cakama3a/Prometheus82/Box_Papers/box_insert.html

PROMETHEUS 82

# Thank you for choosing Prometheus 82

Every Prometheus 82 unit is personally built and tested before shipping. Each device is verified against a reference unit to make sure it performs as expected.

QR code to the Prometheus 82 setup video Scan for the guide youtu.be/Jr5kND7qLt8

## Before your first test

If you follow the current video guide and place the controller correctly, everything should work properly. The setup shown in the guide reflects the current recommended procedure.

Prometheus 82 requires the Prometheus 82 software. Download the latest release here: github.com/cakama3a/Prometheus82/releases

Power Recommendation: Use a 20W (or higher) power adapter. Weak adapters may cause unpredictable test results.

Each tester is checked before dispatch, including a comparison of measured latency behavior against a known-good reference sample. This helps ensure your unit arrives ready to use.

## Care and long-term reliability

- Let the solenoid cool down after test sessions.
- Use the tester as shown in the guide for the best accuracy and service life.

## If something goes wrong

Hardware failures during use are rare, but they are still possible. If a part wears out or stops working, you can request a replacement part.

Replacement parts are free; you only pay for shipping.

Warranty replacement is valid for one year after receipt.

Please use this support option fairly. It is intended for genuine failures, wear, or accidental issues during normal use, not for repeated abuse, misuse, or damage caused by overheating the solenoid.

Hand-built & Tested

Prometheus 82 Input Latency Tester
github.com/cakama3a/Prometheus82
