cakama3a/Prometheus82/COMMERCIAL_LICENSE.md

# Prometheus 82 — Perpetual Commercial License Agreement

**Last Updated:** October 30, 2026

**Version:** 2.1

**Status: Public standard terms for individually issued commercial licenses.** Publication of this file in a public repository does not grant commercial permission. The legally binding terms applicable to a Licensee are the exact version supplied directly by the Licensor before payment (for example, via email attachment or invoice document), together with any expressly agreed individual variations. Public repository updates do not alter an accepted license.

This Perpetual Commercial License Agreement (the "Agreement") governs commercial use of the Prometheus 82 hardware designs, firmware, software, and documentation (collectively, the "Project"), to the extent the Licensor is authorized to license them.

**Author / Copyright Owner:** John Punch (`john@gamepadla.com`, gamepadla.com).

**Licensor:** The Author, or a representative authorized by the Author to grant these rights and expressly identified as the contracting licensor in the commercial invoice. A representative may grant only rights within that authority.

**Licensee:** The legal entity or individual identified as the customer in the commercial invoice issued by the Licensor.

---

### 1. Acceptance, Payment, and Effective Date

**1.1. Agreement by Payment:** Unless the parties expressly agree otherwise in writing before payment, this Agreement becomes effective upon the Licensor's receipt of full payment of the commercial license fee specified in an invoice that meets Section 1.3 (the "Effective Date").

**1.2. No Signature Required:** Payment of that license invoice constitutes the Licensee's full, unconditional acceptance of the supplied version and any expressly agreed variations. No separate physical or digital signature, bilateral agreement exchange, or additional confirmation is required unless specifically agreed before payment.

**1.3. Supplied Version Precedence:** The commercial invoice or its accompanying correspondence must identify the contracting parties, covered Licensee entities, the one-time license fee, applicable taxes, and the applicable license version and date. The definitive applicable text must be supplied directly to the Licensee before payment as an attachment (e.g., PDF or Markdown file) or within the invoice correspondence. The directly supplied text governs and takes precedence over any public repository file or branch (including `main`). An invoice that does not supply the applicable terms must be clarified before payment.

**1.4. No Permission from Preliminary Steps:** Unpaid invoices, preliminary discussions, receipt of this template, downloading repository files, and the purchase of hardware alone do not grant commercial permission.

---

### 2. Definitions and Perpetual Term

**2.1. The Project:** The Author-controlled Prometheus 82 hardware designs (including CAD/STL files), firmware, software, calibration data, and documentation publicly released at https://github.com/cakama3a/Prometheus82 on or before the Effective Date, together with subsequent Author-controlled updates publicly released there as part of Prometheus 82. Separately offered successor products, private designs, and rights belonging to third parties are not included except as separately authorized.

**2.2. Commercial Use:** Any use of the Project for commercial advantage, monetary gain, or business operations, including but not limited to product research and development (R&D), internal quality assurance (QA), competitive benchmarking, marketing, packaging claims, comparative advertising, and monetized media content creation.

**2.3. Perpetual Term:** The license granted hereunder is **perpetual, worldwide, and non-exclusive**. There are no annual renewal fees, recurring subscription charges, per-test or per-controller royalties, or periodic compliance audits. It remains in force indefinitely, subject only to termination under Section 10.

---

### 3. Grant of Rights

Subject to the terms of this Agreement and payment of the applicable fee, the Licensor grants the Licensee a perpetual, worldwide, non-exclusive license to:

- **Deploy & Use:** Install, configure, integrate, and execute the Project internally for Commercial Use across unlimited workstations and testing facilities owned or operated by the Licensee.
- **Modify:** Adapt, customize, alter, or reconfigure the firmware, software, CAD models, wiring schemas, and calibration routines for internal business requirements.
- **Scale Internally:** Construct, 3D-print, assemble, and operate additional Project-based testing units for internal company use without paying additional per-unit license fees.
- **Personnel & Contractors:** Authorize employees and bona fide contractors to operate the Project solely on the Licensee's behalf, provided the Licensee remains responsible for their compliance.
- **Maintain Confidentiality or Publish:** Keep all measurements, internal procedures, evaluation frameworks, and proprietary adaptations strictly confidential, or publish resulting data at the Licensee's sole discretion.

For the internal activities authorized by this Agreement, the Licensee does not need prior approval and has no obligation under this Agreement to publish results or modifications, or to supply internal code or methods to the Author. Applicable third-party license obligations remain unaffected.

This is an alternative commercial permission. For activities it authorizes, the non-commercial-use restriction and prominent user-interface attribution condition in the Personal Use License do not apply. Existing copyright and applicable license notices must remain in retained Project copies; this does not require credit in measurement reports.

---

### 4. Fees, Hardware Transactions, and Scope of Service

**4.1. One-Time Fee:** The license fee is a customized, one-time payment set out in the invoice. Once settled, no future license fees, royalties, or renewal charges will be demanded for the covered Project.

**4.2. Hardware as a Separate Transaction:** Physical evaluation stands, testing hardware, spare parts, and associated shipping are independent transactions handled separately from this intellectual property license. Issues regarding physical shipments—including transit delays, carrier loss, transit damage, or customs clearance procedures—are governed by the terms of the applicable equipment order or carrier policy and do not alter, revoke, or invalidate the granted commercial license. Physical items are delivered subject to the recipient paying any applicable local import duties, taxes, or clearance fees. Specific equipment terms, pricing, shipping arrangements, and replacement policies are established in the respective hardware invoice or correspondence.

**4.3. No Ongoing Support Obligations (Self-Service):** The license fee covers permission to use the Project; it **does not** include dedicated technical support, troubleshooting, individual onboarding, custom firmware development, repair services, periodic recalibration, response deadlines, or service level agreements (SLAs). Usage guidance is based on publicly available documentation and self-service guides. Voluntary assistance does not by itself create a continuing support duty or an SLA. Any guaranteed service requires a separate express written agreement.

**4.4. Development Continuity & Updates:** The Licensee is entitled to use any future public Prometheus 82 updates released by the Author. However, the Licensor and Author have no contractual obligation to maintain continuous development, support future game controllers/protocols, fix issues, or ensure perpetual hosting of repositories, documentation, or companion websites. Discontinuation of the Project does not affect the Licensee's perpetual right to use covered copies already obtained. This section does not remove mandatory legal rights or obligations under a separate equipment or service agreement.

---

### 5. Underlying Project and Third-Party Rights

**5.1. Underlying Project:** The Author retains the intellectual property rights in the original, Author-owned Project material. This Agreement grants permission to use and modify the Project; it does not transfer ownership of the underlying Project.

**5.2. Third-Party Components:** Third-party components, libraries, and assets remain governed by their respective licenses. Nothing in this Agreement restricts or overrides independently granted third-party rights or removes applicable notice, attribution, source-disclosure, or distribution obligations.

---

### 6. Retained Restrictions

**6.1. No Onward Distribution or Resale:** This Agreement does not grant permission to sell, lease, sublicense, or distribute the Project or Project-based testing devices to third parties, or to incorporate Project code or designs into customer products, without a separate written distribution agreement from the Licensor. Independently granted third-party rights under Section 5.2 remain unaffected.

**6.2. No Sublicensing:** The Licensee may not sublicense the commercial rights granted under this Agreement to external entities or subsidiaries not expressly covered in the commercial invoice.

---

### 7. Results, Attribution, and Marketing

**7.1. Voluntary Attribution:** Attribution to Prometheus 82 is **entirely optional**. The Licensee may publish benchmarks, comparative graphs, packaging claims, or reviews without crediting the Project or the Author. If the Licensee chooses to provide credit, truthful statements such as *"Latency measured using Prometheus 82"* or references to `gamepadla.com` are permitted.

**7.2. Commercial Independence & Data Accuracy:** The Licensee is solely responsible for the technical accuracy and integrity of its measurements. The Licensee shall not present results in a manner that falsely implies formal certification, warranty, or official endorsement by the Author or the Prometheus 82 project. No automatic "Certified" badge rights are granted by this Agreement.

**7.3. Mutual Brand Protection:** Neither party may use the other party's trade names, trademarks, or corporate logos in public marketing, press releases, or client lists without prior written permission, except for truthful factual statements expressly permitted under Section 7.1 (such as *"Latency measured using Prometheus 82"*). That exception does not grant logo or certification-badge rights. Private processing of customer names for accounting, invoicing, and license administration is permitted.

---

### 8. Disclaimer of Warranty

TO THE MAXIMUM EXTENT PERMITTED BY APPLICABLE LAW, THE PROJECT AND ALL ASSOCIATED MATERIALS ARE PROVIDED ON AN **"AS IS" AND "AS AVAILABLE" BASIS**, WITHOUT WARRANTY OF ANY KIND, EXPRESS OR IMPLIED, INCLUDING BUT NOT LIMITED TO WARRANTIES OF MERCHANTABILITY, FITNESS FOR A PARTICULAR PURPOSE, TITLE, ACCURACY, AND NON-INFRINGEMENT. THE LICENSEE ASSUMES FULL RESPONSIBILITY AND RISK FOR TESTING PROCEDURES, HARDWARE FABRICATION, DATA ACCURACY, AND BUSINESS DECISIONS DERIVED FROM THE USE OF THE PROJECT.

---

### 9. Limitation of Liability

TO THE MAXIMUM EXTENT PERMITTED BY APPLICABLE LAW, IN NO EVENT SHALL THE LICENSOR OR THE AUTHOR BE LIABLE FOR ANY INDIRECT, INCIDENTAL, SPECIAL, CONSEQUENTIAL, OR PUNITIVE DAMAGES, INCLUDING LOSS OF PROFITS, DATA LOSS, EQUIPMENT DAMAGE, OR BUSINESS INTERRUPTION, ARISING OUT OF OR IN CONNECTION WITH THIS AGREEMENT OR THE USE OF THE PROJECT.

THE AGGREGATE LIABILITY OF THE LICENSOR AND THE AUTHOR ARISING OUT OF OR RELATED TO THIS AGREEMENT SHALL BE STRICTLY LIMITED TO THE ACTUAL LICENSE FEE PAID BY THE LICENSEE UNDER THE APPLICABLE INVOICE.

The exclusions and aggregate monetary limit above are subject to the following exception: nothing in this Agreement excludes or limits liability for fraud, fraudulent misrepresentation, death or personal injury caused by negligence, or any liability that cannot lawfully be excluded or limited under applicable law.

These limitations do not permit the Licensor to withdraw the perpetual license for convenience or impose later renewal charges.

---

### 10. Termination

**10.1. Termination for Material Breach:** The Licensor may terminate this license only in the event of a material breach of this Agreement by the Licensee that remains uncured after thirty (30) days of written notice specifying the breach.

**10.2. Non-Grounds for Termination:** Because this Agreement imposes no such obligations, termination cannot be invoked on grounds of failure to display attribution, non-publication of results, lack of support purchases, or discontinuation of public repository hosting.

**10.3. Effect of Termination:** Upon valid termination, the Licensee must cease further use of the Project for commercial purposes. Lawfully published results, historical reports, and packaging materials created prior to termination remain valid and require no retraction or destruction.

---

### 11. Governing Law and Amendments

**11.1. Governing Law:** This Agreement shall be governed by and construed in accordance with the laws of **England and Wales**, without regard to conflict-of-law principles.

**11.2. Fixed Terms, Precedence, and Modification:** The exact license text supplied directly before payment under Section 1.3, the commercial details in the paid invoice, and any expressly agreed individual variations form the agreement for that Licensee. Individually agreed variations prevail over conflicting standard terms. Later changes to a website, repository file, or public template do not amend an accepted license. Any subsequent amendment requires express written agreement by both parties; neither a unilateral message nor silence is an amendment.

**11.3. Prior Agreements and Earlier Use:** This version does not automatically replace or amend any earlier license agreement, authorize use before the Effective Date, or release claims relating to prior use. Any amendment of an earlier agreement or resolution of prior use requires a separate express agreement identifying its scope.

---

### 12. Contact Information

For commercial license inquiries, invoice requests, or custom distribution inquiries, contact:

- **John Punch**
- **Email:** `john@gamepadla.com`
- **Website:** `https://gamepadla.com`
- **Repository:** `https://github.com/cakama3a/Prometheus82`
