cakama3a/Prometheus82/Arduino.ino

const int CONTACT_PIN = 3;
const int SOLENOID_PIN = 2;
unsigned long PULSE_DURATION_US = 40000;

volatile bool windowActive = false, contactDetected = false, solenoidActive = false;
volatile unsigned long solenoidStartTime_us = 0;

void handleContact() {
    if (!windowActive) return;
    if (!contactDetected) {
        Serial.write('S');
        contactDetected = true;
        return;
    }
}

void setup() {
    Serial.begin(115200);
    pinMode(CONTACT_PIN, INPUT_PULLUP);
    pinMode(SOLENOID_PIN, OUTPUT);
    const char* FWV = "1.1.1";
    
    attachInterrupt(digitalPinToInterrupt(CONTACT_PIN), handleContact, FALLING);
    
    for (int i = 0; i < 3; i++) {
        digitalWrite(SOLENOID_PIN, HIGH);
        delay(PULSE_DURATION_US / 1000);
        digitalWrite(SOLENOID_PIN, LOW);
        delay(200);
    }
    Serial.write('R');
    Serial.write('V');
    for (int i = 0; FWV[i] != 0; i++) {
        Serial.write(FWV[i]);
    }
    Serial.write('\n');
}

void loop() {
    if (Serial.available() > 0) {
        char cmd = Serial.read();
        
        // Fast handling of 'D' command for delay test
        if (cmd == 'D') {
            Serial.write('R');
            return; // Exit to avoid further checks
        }
        
        // Other commands are processed as before
        if (cmd == 'T') {
            contactDetected = false;
            digitalWrite(SOLENOID_PIN, HIGH);
            solenoidStartTime_us = micros();
            solenoidActive = true;
            windowActive = true;
        }
        else if (cmd == 'P') {
            unsigned long startTime = millis();
            while (Serial.available() < 2 && (millis() - startTime) < 50) {
                ;
            }
            if (Serial.available() >= 2) {
                unsigned long duration_ms = (Serial.read() << 8) | Serial.read();
                PULSE_DURATION_US = duration_ms * 1000;
                Serial.write('A');
            }
            while (Serial.available() > 0) {
                Serial.read();
            }
        }
        else if (cmd == 'Q') {
            int state = digitalRead(CONTACT_PIN);
            Serial.write(state == LOW ? 'H' : 'U');
        }
    }

    if (solenoidActive && (micros() - solenoidStartTime_us >= PULSE_DURATION_US)) {
        digitalWrite(SOLENOID_PIN, LOW);
        solenoidActive = false;
    }
}
