cakama3a/Prometheus82/(commit log)

2025-04-16 Arduino Hex Added
2025-07-05 Update
    Algorithm for testing your own delay for Arduino
2025-07-07 SLC
    Self Latency Calibration
2025-07-12 5.2.2.0
    The basic logic of solenoid timing compensation
2025-07-25 Change test speed
    Change the number and speed of tests so that the overheating of the solenoid has less impact on the final results.
    [Python.py]
2025-07-29 Driver name
2025-07-29 RAW samples
2025-07-29 Filter change
2025-07-29 5.2.3.1
    Update to version 5.2.3.1:
    - Added hardware test mode for solenoid and sensor functionality
    - Reduced TEST_ITERATIONS from 500 to 400
    - Adjusted quantile filters (LOWER_QUANTILE: 0.05->0.02, UPPER_QUANTILE: 0.95->0.98)
    - Added CSV export functionality for test results
    - Improved test type selection with hardware test option
    - Added warning for high contact delay (>1.2ms)
    - Optimized serial connection handling with context manager
    - Included raw results in CSV export
    - Minor code refactoring and cleanup
2025-10-19 Revert "Keyboard And Mouse Test Support"
    This reverts commit abd7da608dad43328bead8c553c99696cdcb16ec.
    [Python.py]
2025-10-19 5.2.3.3
    Stable version fix
    [Python.py]
2025-12-10 Update gamepad testing instructions in README
    Added important note about stick tension adjustment and updated test program instructions.
2026-01-22 5.2.4.3
    An update that adds a separate reversible solenoid for testing the stick. For previous devices with a single test solenoid, use this branch: https://github.com/cakama3a/Prometheus82/tree/One_Solenoid
2026-01-22 Update README with 2026 sensor and solenoid details
    Added information about the new sensor and solenoid for testing sticks in 2026, along with a link to the latest stable release for older versions.
2026-01-22 Clarify missing files for Prometheus 82
    Added note about missing STL file for reverse sensor and case.
2026-01-22 Update README with case STL file clarification
    Clarified the note about STL files for the P82 board case in the README.
2026-01-23 Enhance README with assembly components information
    Added details about individual 3D printed parts and main electronic components.
2026-01-23 Revise Thingiverse link description in README
    Updated the link description for the 3D printed parts.
2026-01-27 5.2.4.4
    Note: reverse sensor
    [Python.py]
2026-02-05 Update video instructions link in README
    Updated video instructions link for the new reversible solenoid.
2026-02-05 Add reversible sensor components section to README
    Added a section for reversible sensor components with details on various components, their prices, and links.
2026-02-05 Revise reversible sensor components section
    Updated the section on reversible sensor components to improve clarity and organization.
2026-03-14 Not Full deflect Error
    [Python.py]
2026-03-14 Update README with user guide and 2026 sensor info
    Added a user guide link and updated information about a new sensor and solenoid layout for 2026.
2026-03-19 Revise sensor trigger and update calculation method
    Updated sensor trigger description and removed manual offset calculation note. Added important update regarding new hardware design.
2026-03-19 Update README with link to Arduino IDE
2026-04-07 Add thank-you page and ignore __pycache__
    Add a printable thank-you HTML (box_insert.html) and a Thank You.pdf for customers. Remove committed Python bytecode (__pycache__/Python.cpython-312.pyc) and update .gitignore to ignore the __pycache__ directory to prevent future pyc files from being tracked. The HTML includes QR/support links and purchase/care information for Prometheus 82.
2026-04-07 Use separate cooling timers for button and stick
    Introduce per-test-type cooling state: create _TEMP_DIR and separate LAST_TEST_TIME_FILE_BUTTON / LAST_TEST_TIME_FILE_STICK files. Update check_cooling_period to accept an optional test_type (aggregating warnings when None, or reporting specific remaining time for BUTTON/STICK). Make get_cooling_remaining_seconds and save_test_completion_time accept test_type and read/write the appropriate file; save_test_completion_time now logs which timer was set. Update main usage to pass test_type when checking and saving cooling state. Handles legacy file formats and IO errors as before.
    [Python.py]
2026-05-06 Dynamic Switching to stronger pulse
2026-05-06 Обмеження тестів при повільному стронг режимі до 200
2026-05-11 Refactor cooling checks and clean up flow
    Centralize cooling-time logic by using get_cooling_remaining_seconds() instead of duplicating file parsing in check_cooling_period(), simplifying both the multi-type and single-type branches and printing consolidated warnings. Broadened exception handling in check_cooling_period to always return True on error. Removed redundant close_test_window() calls and an empty method, and simplified detect_gamepad_mode to delegate to detect_input_mode (removed unused MODES). Cleaned up several blank-line prints in the ASCII header and minor whitespace/flow refinements.
    [Python.py]
2026-05-11 Refactor UI and consolidate timeout limits
    Add a general MAX_CONSECUTIVE_TIMEOUTS constant and unify timeout handling so tests use a type-specific limit (stick vs other). Revamp render_test_window with a new dark-themed UI: header, status text, progress bar, larger average-latency display and a live indicator. Improve and consolidate the error message shown when too many consecutive timeouts occur. These changes improve usability and make test-abort behavior clearer and safer across different test types.
    [Python.py]
2026-05-11 Enhance UI and pre-render background
    Update Python.py to improve the app's UI, visuals and rendering efficiency. Changes include: added math import; new _bg_surface attribute and _pre_render_bg() to pre-render static background/header; revamped start screen (larger title, animated glow, gradient background, updated button and fonts); redesigned render_test_window with header/card layout, animated progress bar, latency dashboard (big average display, stats), and a redesigned LIVE badge; adjusted status messages and key-selection display; and changed the render loop to skip rendering while measuring to preserve measurement accuracy. These changes reduce per-frame drawing cost and improve prese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
    [Python.py]
2026-05-11 Use protocol-aware axis pairing for joysticks
    Replace the simple even/odd partner-axis heuristic with protocol-aware axis pairing used by Stick Tracer. Adds INPUT_MODE_AXES and INPUT_MODE_AXIS_PAIRS tables and updates LatencyTester to look up partner_axis from the detected input mode (self._detected_mode), falling back to the even/odd heuristic if no pair matches. Also adds a brief docstring note about Stick Tracer standard and preserves existing behavior when partner axis cannot be resolved.
    [Python.py]
2026-05-11 Add protocol-aware detection and axis pairing
    Introduce protocol support to LatencyTester by adding an optional protocol parameter and storing it for protocol-aware axis pairing. Refactor input detection: simplify detect_input_mode signature and logic (consolidate Switch detection, rename axes param, add docstring) and remove the old INPUT_MODE_AXES mapping. Update INPUT_MODE_AXIS_PAIRS to include a Default fallback and use the stored protocol when resolving partner axes. Simplify joystick warmup in detect_gamepad_mode and pass the detected_mode into LatencyTester when constructing the tester to enable protocol-specific behavior.
2026-05-11 5.2.5.0
    UI and Visuals
    New Testing Window: Redesigned the testing interface with a better layout and a real-time results dashboard.
    Progress Indicators: Added a visual progress bar and "LIVE/FINISHED" status badges.
    Cooling Dashboard: Replaced the simple text warning with a formatted status box in the console to track solenoid cooling time.
    Measurement Accuracy
    Process Priority: The app now automatically sets itself to High Priority on Windows during testing to reduce OS interference.
    Jitter Reduction: Python's Garbage Collector is now disabled during the measurement phase to prevent random latency spikes.
    Loop Optimization: The testing loop is more efficient, separating high-speed data coll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
    [Python.py]
2026-05-14 Keep Pygame responsive during console input
    Bump version to 5.2.5.1 and add LAST_RENDER_CALL to allow background rendering while waiting for console input. Extend get_input_with_countdown(prompt, menu=None, show_cooling=True) to optionally disable cooling display and to pump Pygame events (calling LAST_RENDER_CALL) so the Pygame window remains responsive. Update LatencyTester to set LAST_RENDER_CALL and change post-test behavior so the window no longer blocks the console: log completion messages instead of waiting for window close, and keep rendering available for background updates. Replace several blocking input() calls with get_input_with_countdown(..., show_cooling=False) to avoid interf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
    [Python.py]
2026-05-14 Require 200 samples before upload; clarify prompt
    Clarify the test start message and enforce a minimum sample requirement for uploading results to Gamepadla.com. Changes: - Update test window prompt to instruct user to switch to the graphical window and press START TEST. - Grey out "Open on Gamepadla.com" when results were already uploaded or when there are fewer than 200 valid samples. - Add a runtime guard that prevents uploading when stats['valid_samples'] < 200 and prints an explanatory error/guidance message.
    [Python.py]
2026-05-14 Add max_len to get_input_with_countdown
    Introduce an optional max_len parameter to get_input_with_countdown to limit input length. On non-Windows platforms input is truncated to max_len; in the interactive loop printable chars are only appended while under the limit and stdout is flushed after each char. Small UI tweaks: replaced a raw print with print_info when the test window is ready, removed a duplicate startup prompt, updated the gamepad-name prompt to indicate a 60-char limit, enforce non-empty gamepad names (print_error on empty), and separate/validate the connection choice mapping. These changes tighten input handling and improve feedback for the test setup flow.
    [Python.py]
2026-05-22 5.3.0.0 - Refactor input/timing and harden latency measurement
    Decouple and robustly handle Arduino 'S' (sensor) and gamepad 'G' timestamps: capture both as absolute microsecond timestamps, track per-cycle state (_cycle_active, _s_received, _g_received) and compute latency as G - S plus contact_delay. Flush serial input before firing the solenoid to discard stale 'S' bytes and replace event-based joystick/button/key detection with lightweight polling (pygame.event.clear, get_button/get_pressed/get_axis) to avoid missed inputs and queue overflow. Add dynamic glitch detection and rejection (based on running average/jitter), improved timeout and consecutive-miss handling, and mark early gamepad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
    [Python.py]
2026-06-06 Add Steam Controller Direct HID support
    Bump version to 5.3.0.1 and add direct Steam Controller (SC2026) HID support via a new SteamControllerDirect class. Gracefully import the optional Python 'hid' package and provide device discovery, diagnostics, feature/heartbeat commands, input parsing (axes/buttons) and helper labels/IDs. Integrate the direct controller into LatencyTester (poll/update paths for axis/button/hit detection), auto-select the first Steam device if present, and print diagnostic tips when no devices are found. Add clear_console_key_buffer for Windows to avoid stray key presses in input loops and improve menu input handling. Map the detected "Steam Direct" protocol to a serve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
    [Python.py]
2026-06-11 Improve gamepad selection and Steam Direct support
    Collect available inputs into a unified options list (SteamControllerDirect and pygame joysticks), present a single selection menu, and handle zero/one/multiple device cases. Add clearer diagnostics and tips when no devices are found or hid is missing, improve input validation and error messages, and defer opening the Steam Direct device until it is actually selected. Ensure selected device is initialized and print whether it was autoselected or chosen by the user.
    [Python.py]
2026-07-01 Add warm-up round to latency testing
    Implement a calibration round that is excluded from measurement counts. The first iteration (i=0) now serves as a warm-up and does not contribute to invalid measurement counts. Similarly, the first timeout encountered is ignored. This helps stabilize measurements by allowing the system to settle before recording actual test results.
    [Python.py]
2026-07-07 Organize box materials and add positioning guide
    Move box_insert.html to Box_Papers directory and add positioning guide assets (PNG and PDF). Includes a Python script to generate a combined PDF guide. Update README to reference the positioning guide in setup instructions and tip section.
2026-07-07 Refine box insert layout and typography
    Adjust CSS dimensions and font sizes in box insert design:
    - Reduced font sizes: ascii-title (7.5px → 6.2px), h1 (22px → 20px), lead (14px → 13px)
    - Added negative letter-spacing to ascii-title
    - Reduced QR card width (160px → 150px)
    - Added new .brand class with flex properties for better layout control
2026-07-07 Update box insert with SVG logo and halftone PDF
    - Replace ASCII art PROMETHEUS 82 logo with SVG graphic
    - Update typography to Inter font with letter spacing
    - Add halftone (ink-saving) PDF variant generation
    - Update QR code link to shortened youtu.be URL
    - Refactor PDF generation script for better code organization
    - Add logo files to Logos directory
2026-07-08 Update P82 SVG badge; refresh license & PDFs
    Expand and refactor the P82 SVG: widened viewBox, added a masked yellow badge for the '82' numerals, and reorganized/cleaned the wordmark paths (PROMETHEUS + BADGE). Replace box insert PDFs (regular & halftone). Update COMMERCIAL_LICENSE.md: bump Last Updated date, renumber/retitle sections (Ownership, Restrictions, Publication, Disclaimer, Limitation, Termination, Governing Law, Contact), adjust cross-references (attribution -> 7.2), and clarify ownership of test data.
2026-07-15 Replace SVG masks with fill-rule cutouts
    Convert logo SVGs from using mask-based badge cutouts to inline path definitions with fill-rule="evenodd", simplifying the rendering approach.
    Also update README documentation:
    - Remove outdated 2026 hardware update notices
    - Simplify measurement calculation explanation
    - Streamline "How to Use" section formatting
    - Mark cable assembly video as optional
    - Add Retro Fighters to commercial licenses table
